NightLaneOrg/nr-si468x-dev/pcb/Si468x.kicad_pcb

## KiCad design pcb/Si468x.kicad_pcb (2026-10-27)

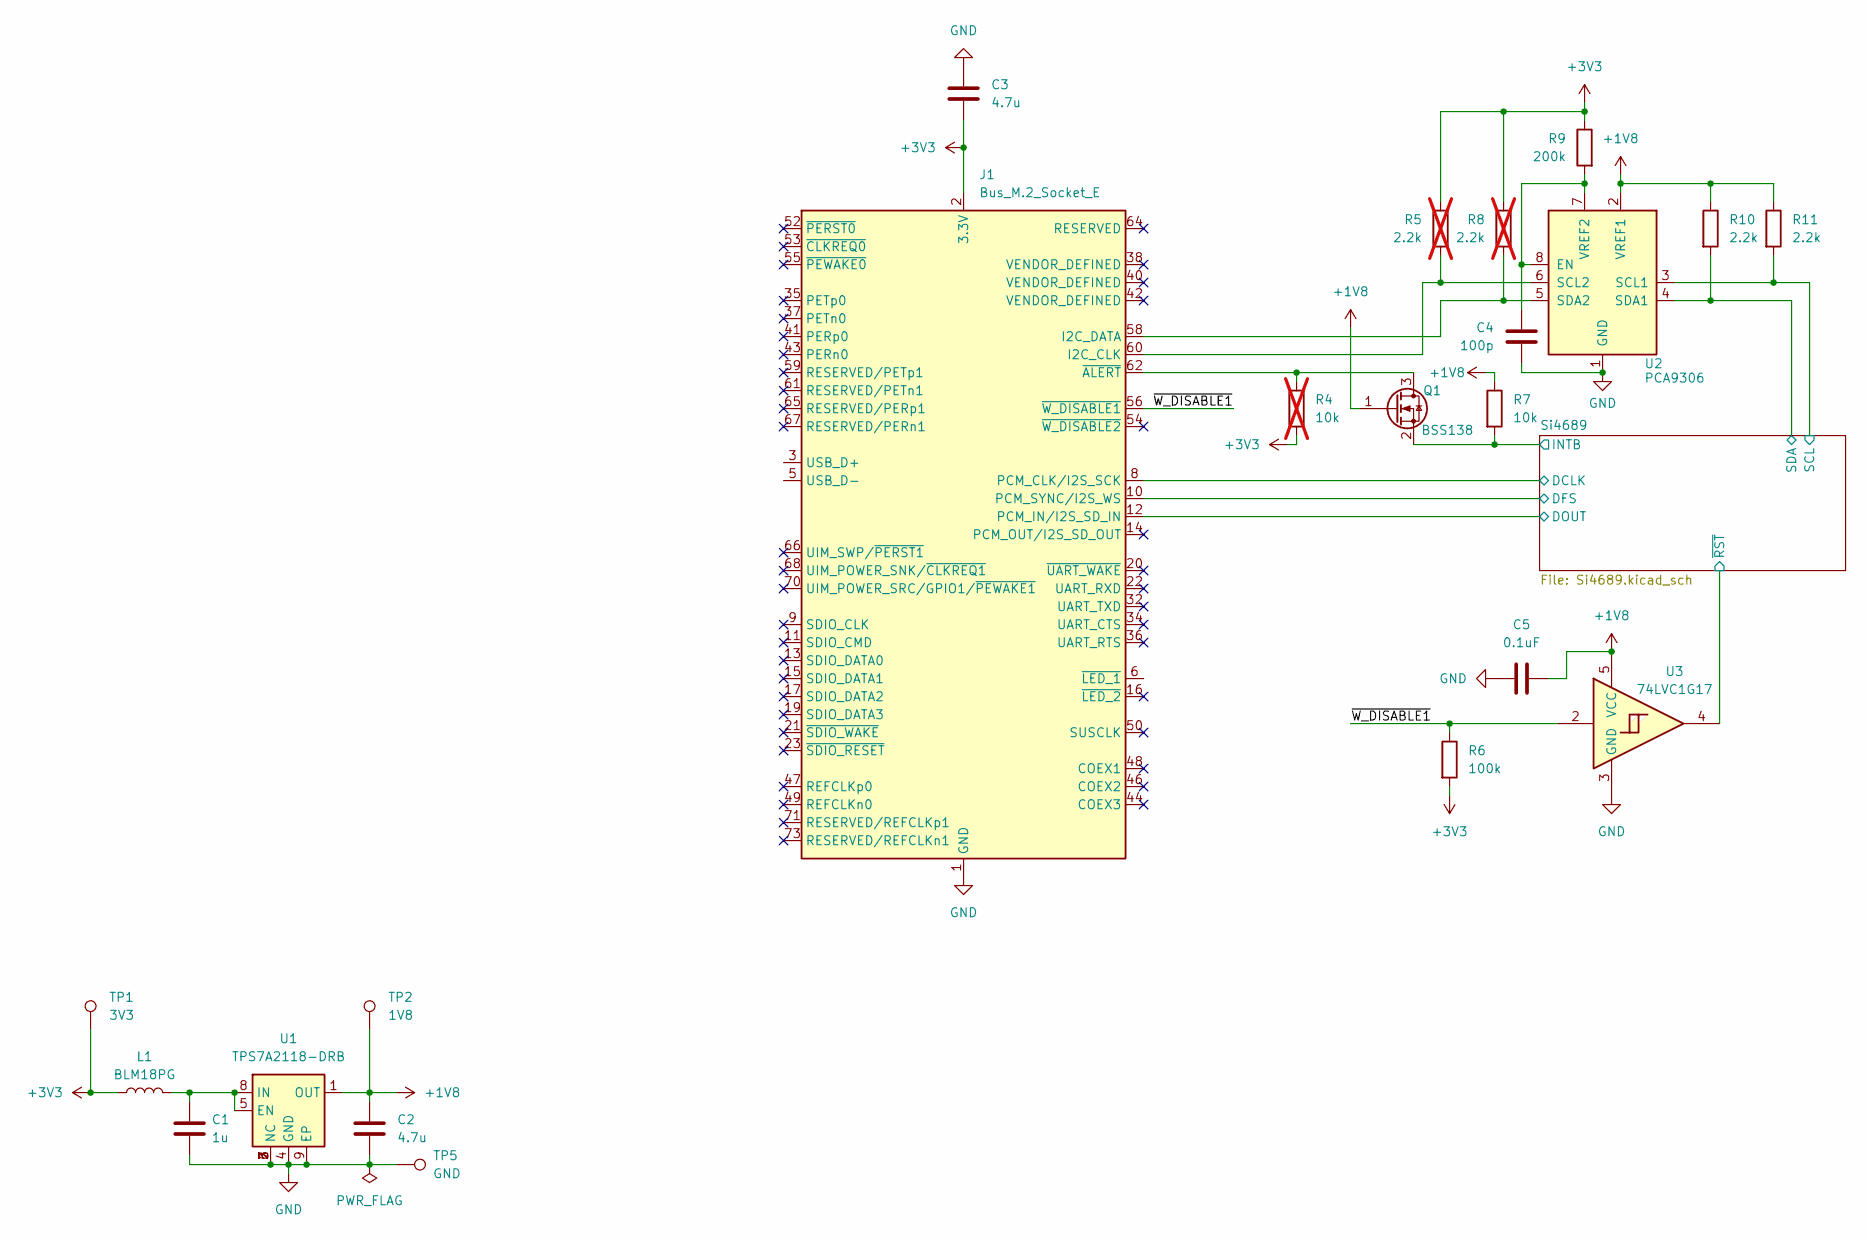
[picture p1: schematic Si468x.kicad_sch]

Parts:
C1: 1u; C_0603_1608Metric; LCSC C29936
C2, C3: 4.7u; C_0603_1608Metric; LCSC C18185770
C4: 100p; C_0402_1005Metric; LCSC C281751
C5: 0.1uF; C_0402_1005Metric; LCSC C77020
J1: Bus_M.2_Socket_E; M.2_2230-xx-E
L1: BLM18PG; L_0603_1608Metric; LCSC C80165
Q1: BSS138; SOT-23; LCSC C82045
R4: 10k; R_0402_1005Metric; LCSC C60490; not fitted
R5, R8: 2.2k; R_0402_1005Metric; LCSC C114762; not fitted
R6: 100k; R_0402_1005Metric; LCSC C60491
R7: 10k; R_0402_1005Metric; LCSC C60490
R9: 200k; R_0402_1005Metric; LCSC C60490
R10, R11: 2.2k; R_0402_1005Metric; LCSC C114762
TP1: 3V3; TestPoint_Pad_D1.0mm
TP2: 1V8; TestPoint_Pad_D1.0mm
TP5: GND; TestPoint_Pad_D1.0mm
U1: TPS7A2118-DRB; Texas_DRB_VSON_8; LCSC C35469250
U2: PCA9306; VSSOP-8_2.3x2mm_P0.5mm
U3: 74LVC1G17; Texas_R-PDSO-G5_DCK-5; LCSC C10425

Connections:
+1V8: C2.1, C5.2, Q1.1 (G), R7.1, R10.1, R11.1, TP2.1 (1_1), U1.1 (OUT), U2.2 (VREF1), U3.5 (VCC); also elsewhere on the board
+3V3: C3.2, J1.2 (3.3V), J1.4 (3.3V), J1.72 (3.3V), J1.74 (3.3V), L1.1, R4.2, R5.1, R6.2, R8.1, R9.1, TP1.1 (1_1)
/Si4689/DCLK: J1.8 (PCM_CLK/I2S_SCK); also elsewhere on the board
/Si4689/DFS: J1.10 (PCM_SYNC/I2S_WS); also elsewhere on the board
/Si4689/DOUT: J1.12 (PCM_IN/I2S_SD_IN); also elsewhere on the board
/Si4689/INTB: Q1.2 (S), R7.2; also elsewhere on the board
/Si4689/SCL: R11.2, U2.3 (SCL1); also elsewhere on the board
/Si4689/SDA: R10.2, U2.4 (SDA1); also elsewhere on the board
/Si4689/~RST: U3.4; also elsewhere on the board
/~W_DISABLE1: J1.56 (~W_DISABLE1), R6.1, U3.2
GND: C1.2, C2.2, C3.1, C4.2, C5.1, J1.1 (GND), J1.7 (GND), J1.18 (GND), J1.33 (GND), J1.39 (GND), J1.45 (GND), J1.51 (GND), J1.57 (GND), J1.63 (GND), J1.69 (GND), J1.75 (GND), TP5.1 (1_1), U1.2 (NC), U1.3 (NC), U1.4 (GND), U1.6 (NC), U1.7 (NC), U1.9 (EP), U2.1 (GND), U3.3 (GND); also elsewhere on the board
unnamed: J1.60 (I2C_CLK), R5.2, U2.6 (SCL2)
unnamed: J1.58 (I2C_DATA), R8.2, U2.5 (SDA2)
unnamed: J1.62 (~ALERT), Q1.3 (D), R4.1
unnamed: C1.1, L1.2, U1.5 (EN), U1.8 (IN)
unnamed: C4.1, R9.2, U2.7 (VREF2), U2.8 (EN)

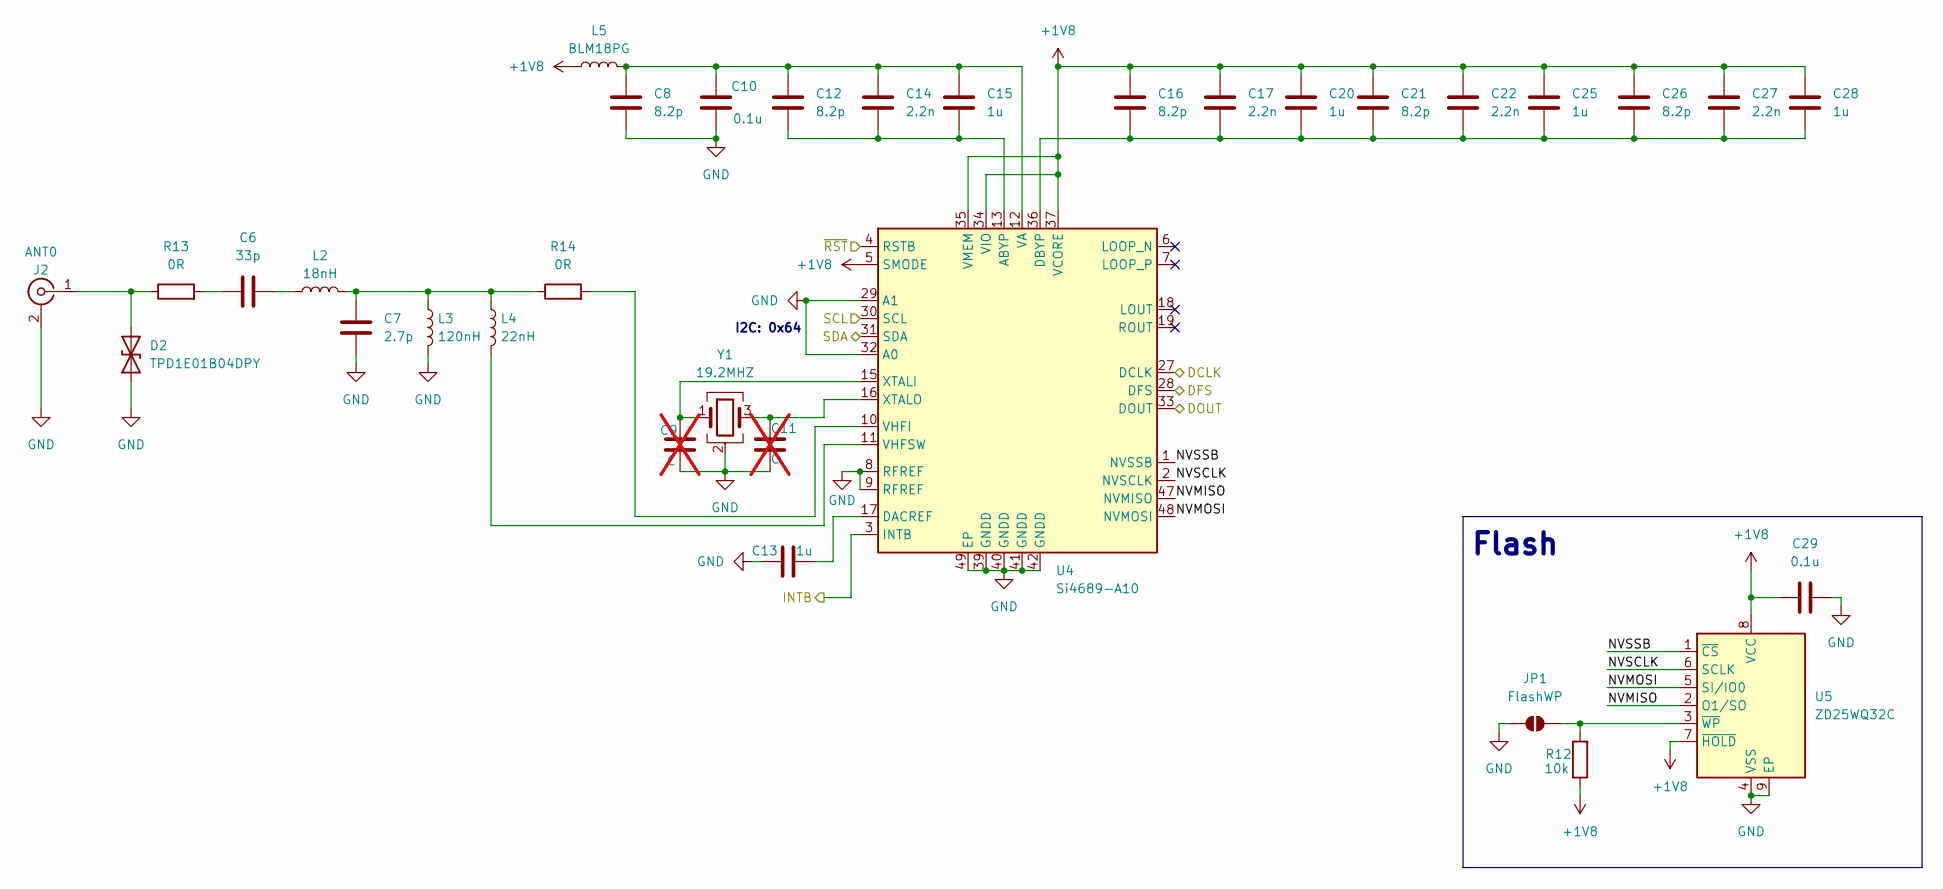
[picture p2: schematic Si4689.kicad_sch]

Parts:
C6: 33p; C_0402_1005Metric; LCSC C70465
C7: 2.7p; C_0402_1005Metric; LCSC C76904
C8, C12, C16, C21, C26: 8.2p; C_0402_1005Metric; LCSC C76984
C9, C11: C; C_0402_1005Metric; not fitted
C10, C29: 0.1u; C_0402_1005Metric; LCSC C77020
C13, C15, C20, C25, C28: 1u; C_0402_1005Metric; LCSC C576449
C14, C17, C22, C27: 2.2n; C_0402_1005Metric; LCSC C126534
D2: TPD1E01B04DPY; Texas_DPY0002A_0.6x1mm_P0.65mm; LCSC C779389
J2: ANT0; IPEX_20449-001E-03; LCSC C784401
JP1: FlashWP; SolderJumper-2_P1.3mm_Open_RoundedPad1.0x1.5mm
L2: 18nH; L_0402_1005Metric; LCSC C668381
L3: 120nH; L_0402_1005Metric; LCSC C113123
L4: 22nH; L_0402_1005Metric; LCSC C703122
L5: BLM18PG; L_0603_1608Metric; LCSC C80165
R12: 10k; R_0402_1005Metric; LCSC C60490
R13, R14: 0R; R_0402_1005Metric; LCSC C106231
U4: Si4689-A10; QFN-48_EP_7x7_Pitch0.5mm; LCSC C1526087
U5: ZD25WQ32C; Winbond_USON-8-1EP_3x2mm_P0.5mm_EP0.2x1.6mm; LCSC C5258281
Y1: 19.2MHZ; Crystal_SMD_3225-4Pin_3.2x2.5mm; LCSC C1986852

Connections:
+1V8: C16.1, C17.1, C20.1, C21.1, C22.1, C25.1, C26.1, C27.1, C28.1, C29.1, L5.1, R12.1, U4.5 (SMODE), U4.34 (VIO), U4.35 (VMEM), U4.37 (VCORE), U5.7 (~HOLD), U5.8 (VCC); also elsewhere on the board
/Si4689/DCLK: U4.27 (DCLK); also elsewhere on the board
/Si4689/DFS: U4.28 (DFS); also elsewhere on the board
/Si4689/DOUT: U4.33 (DOUT); also elsewhere on the board
/Si4689/INTB: U4.3 (INTB); also elsewhere on the board
/Si4689/NVMISO: U4.47 (NVMISO), U5.2 (O1/SO)
/Si4689/NVMOSI: U4.48 (NVMOSI), U5.5 (SI/IO0)
/Si4689/NVSCLK: U4.2 (NVSCLK), U5.6 (SCLK)
/Si4689/NVSSB: U4.1 (NVSSB), U5.1 (~CS)
/Si4689/SCL: U4.30 (SCL); also elsewhere on the board
/Si4689/SDA: U4.31 (SDA); also elsewhere on the board
/Si4689/~RST: U4.4 (RSTB); also elsewhere on the board
GND: C7.2, C8.2, C9.2, C10.2, C11.2, C13.1, C29.2, D2.1 (A1), J2.2 (Ext), JP1.1 (A), L3.2, U4.8 (RFREF), U4.9 (RFREF), U4.29 (A1), U4.32 (A0), U4.39 (GNDD), U4.40 (GNDD), U4.41 (GNDD), U4.42 (GNDD), U4.49 (EP), U5.4 (VSS), U5.9 (EP), Y1.2 (G), Y1.4 (G); also elsewhere on the board
unnamed: C6.1, R13.2
unnamed: C6.2, L2.1
unnamed: C7.1, L2.2, L3.1, L4.1, R14.1
unnamed: D2.2 (A2), J2.1 (In), R13.1
unnamed: JP1.2 (B), R12.2, U5.3 (~WP)
unnamed: C12.2, C14.2, C15.2, U4.13 (ABYP)
unnamed: C13.2, U4.17 (DACREF)
unnamed: C16.2, C17.2, C20.2, C21.2, C22.2, C25.2, C26.2, C27.2, C28.2, U4.36 (DBYP)
unnamed: C8.1, C10.1, C12.1, C14.1, C15.1, L5.2, U4.12 (VA)
unnamed: R14.2, U4.10 (VHFI)
unnamed: L4.2, U4.11 (VHFSW)
unnamed: C9.1, U4.15 (XTALI), Y1.1
unnamed: C11.1, U4.16 (XTALO), Y1.3

Notes on the sheet:
I2C: 0x64
Flash

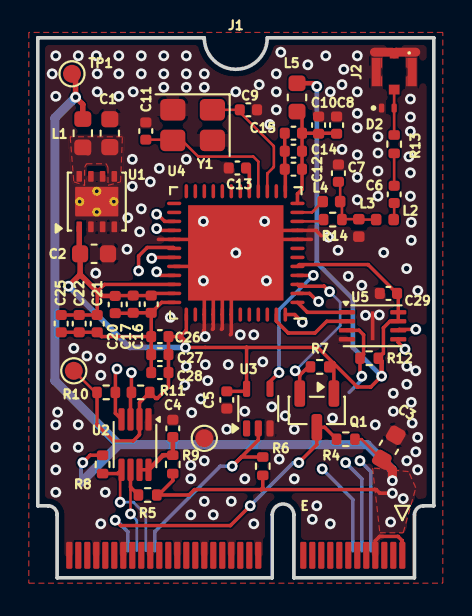
[picture p3: board Si468x.kicad_pcb from above]

Board: 4 copper layers, 22.0 x 30.0 mm, 55 parts (1 on the bottom side), 33 nets.
