NightLaneOrg/nr-si468x-dev/adapters/raspberry-pi/raspberry-pi-adapter.kicad_pcb

## KiCad design adapters/raspberry-pi/raspberry-pi-adapter.kicad_pcb (2026-10-27)

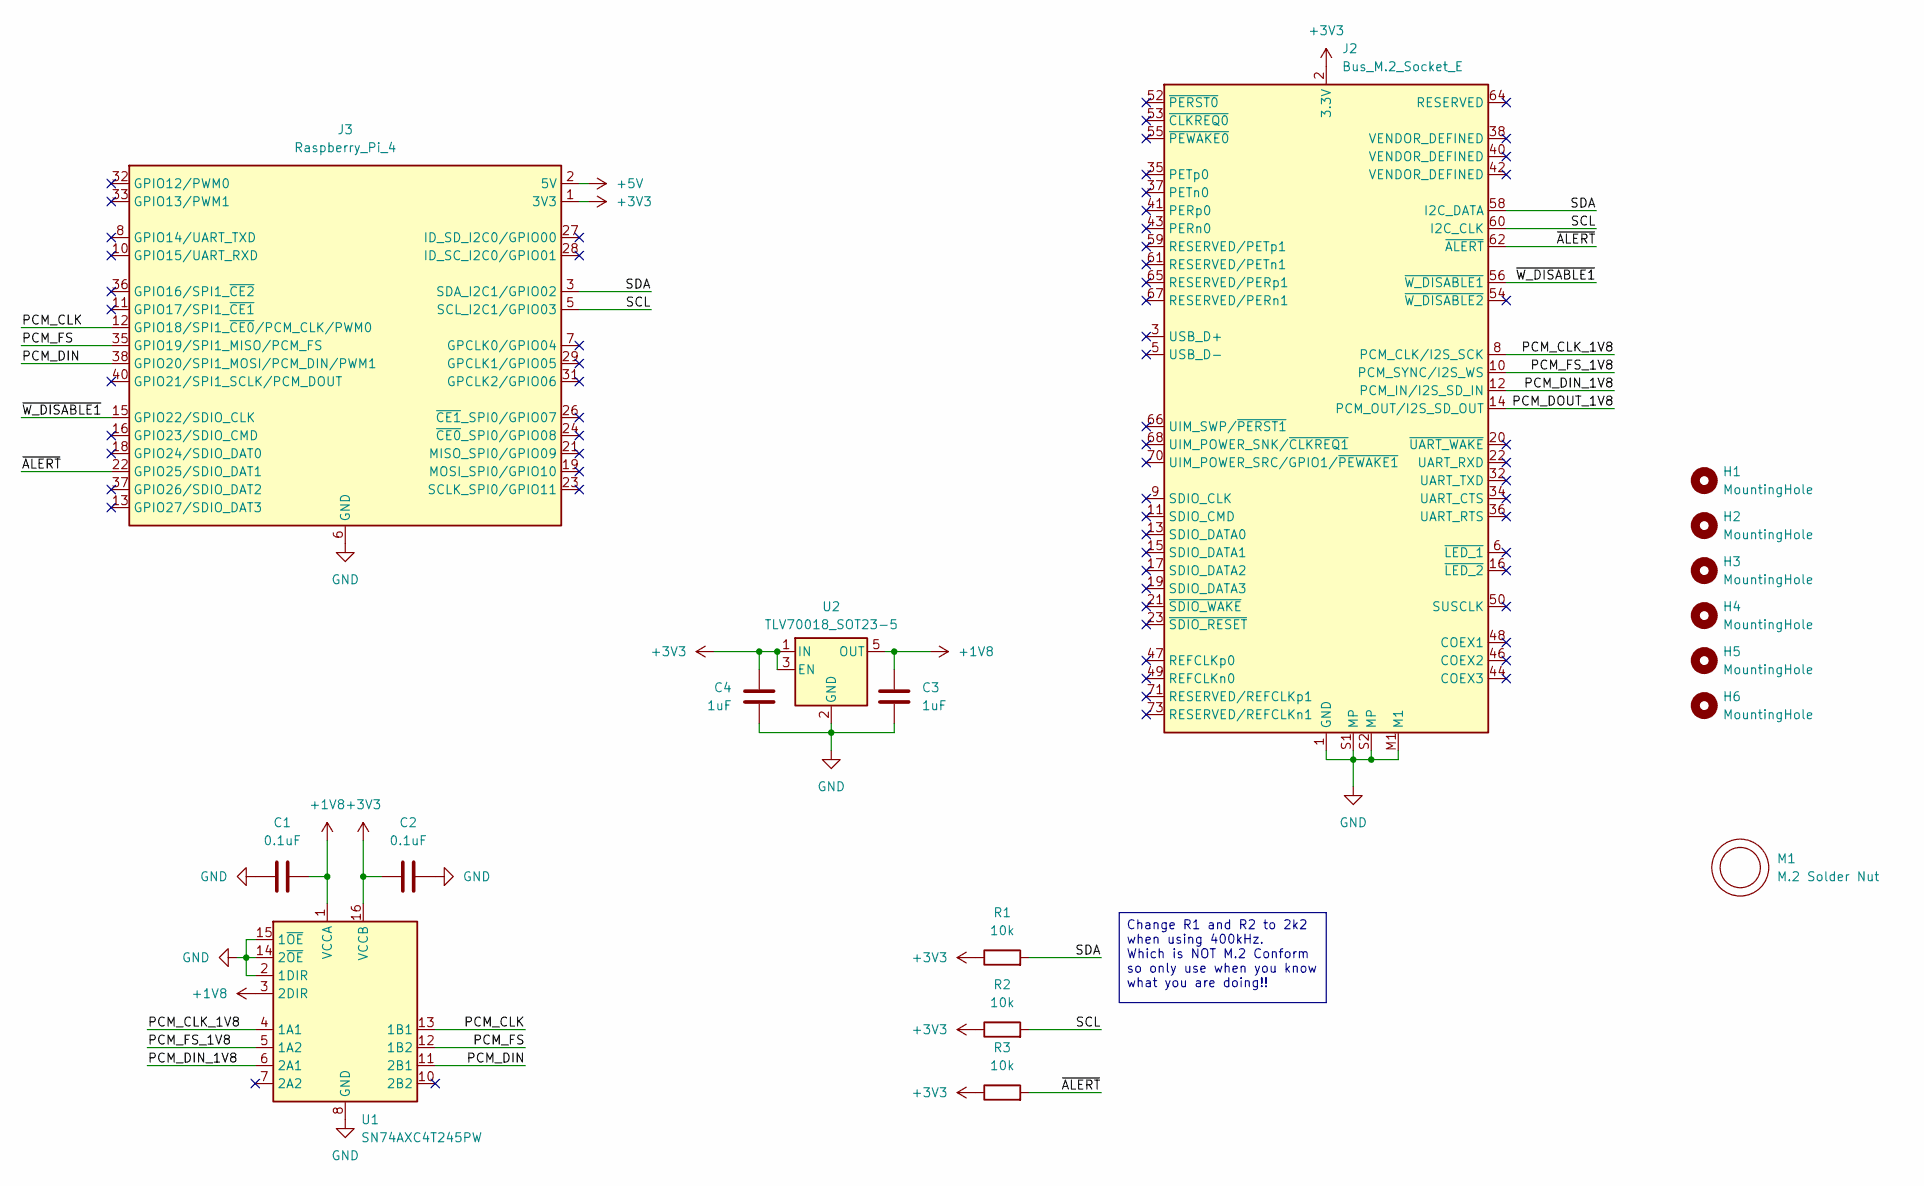
[picture p4: schematic raspberry-pi-adapter.kicad_sch]

Parts:
C1, C2: 0.1uF; C_0603_1608Metric; LCSC C14663
C3, C4: 1uF; C_0603_1608Metric; LCSC C15849
H1, H2, H3, H4, H5, H6: MountingHole; MountingHole_2.7mm_M2.5
J2: Bus_M.2_Socket_E; JAE_SM3ZS067U310AER1200; LCSC C4755078
J3: Raspberry_Pi_4
M1: M.2 Solder Nut; LCSC C5221772
R1, R2, R3: 10k; R_0603_1608Metric; LCSC C25804
U1: SN74AXC4T245PW; TSSOP-16_4.4x5mm_P0.65mm; LCSC C2867798
U2: TLV70018_SOT23-5; SOT-23-5; LCSC C79924

Connections:
+1V8: C1.1, C3.1, U1.1 (VCCA), U1.3 (2DIR), U2.5 (OUT)
+3V3: C2.2, C4.1, J2.2 (3.3V), J2.4 (3.3V), J2.72 (3.3V), J2.74 (3.3V), J3.1 (3V3), J3.17 (3V3), R1.1, R2.1, R3.1, U1.16 (VCCB), U2.1 (IN), U2.3 (EN)
+5V: J3.2 (5V), J3.4 (5V)
/PCM_CLK: J3.12 (GPIO18/SPI1_~CE0/PCM_CLK/PWM0), U1.13 (1B1)
/PCM_CLK_1V8: J2.8 (PCM_CLK/I2S_SCK), U1.4 (1A1)
/PCM_DIN: J3.38 (GPIO20/SPI1_MOSI/PCM_DIN/PWM1), U1.11 (2B1)
/PCM_DIN_1V8: J2.12 (PCM_IN/I2S_SD_IN), U1.6 (2A1)
/PCM_DOUT_1V8: J2.14 (PCM_OUT/I2S_SD_OUT)
/PCM_FS: J3.35 (GPIO19/SPI1_MISO/PCM_FS), U1.12 (1B2)
/PCM_FS_1V8: J2.10 (PCM_SYNC/I2S_WS), U1.5 (1A2)
/SCL: J2.60 (I2C_CLK), J3.5 (SCL_I2C1/GPIO03), R2.2
/SDA: J2.58 (I2C_DATA), J3.3 (SDA_I2C1/GPIO02), R1.2
/~ALERT: J2.62 (~ALERT), J3.22 (GPIO25/SDIO_DAT1), R3.2
/~W_DISABLE1: J2.56 (~W_DISABLE1), J3.15 (GPIO22/SDIO_CLK)
GND: C1.2, C2.1, C3.2, C4.2, J2.1 (GND), J2.7 (GND), J2.18 (GND), J2.33 (GND), J2.39 (GND), J2.45 (GND), J2.51 (GND), J2.57 (GND), J2.63 (GND), J2.69 (GND), J2.75 (GND), J2.M1, J2.S1 (MP), J2.S2 (MP), J3.6 (GND), J3.9 (GND), J3.14 (GND), J3.20 (GND), J3.25 (GND), J3.30 (GND), J3.34 (GND), J3.39 (GND), U1.2 (1DIR), U1.8 (GND), U1.9 (GND), U1.14 (2~OE), U1.15 (1~OE), U2.2 (GND)

Notes on the sheet:
Change R1 and R2 to 2k2 when using 400kHz. Which is NOT M.2 Conform so only use when you know what you are doing!!

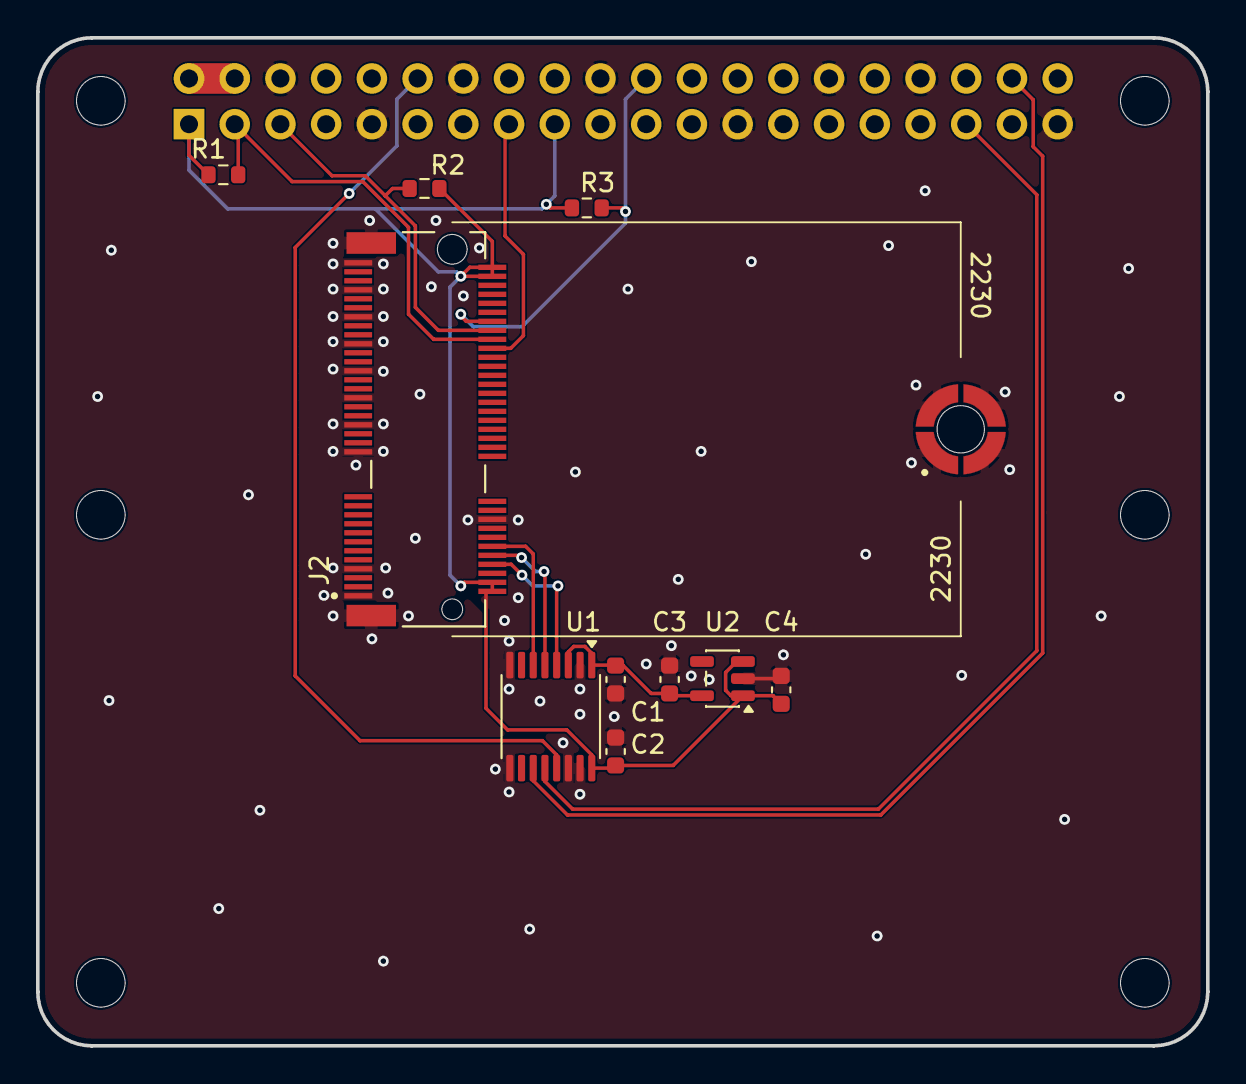
[picture p5: board raspberry-pi-adapter.kicad_pcb from above]

Board: 2 copper layers, 65.0 x 56.0 mm, 17 parts (1 on the bottom side), 14 nets.
